imran7976/automated-waste-segregation-robot/hardware/bill_of_materials.md

# Itemized Bill of Materials (BOM) & Turnkey Cost Analysis

The prototype was constructed with extreme affordability as a primary engineering objective, achieving full functionality at under $50 USD. The procurement invoices are itemized below in Bangladeshi Taka (BDT) and US Dollars (USD).

| Subsystem Component | Model / Specifications | Qty | Unit Cost (BDT) | Total Cost (BDT) | Cost (USD) |
| :--- | :--- | :---: | :---: | :---: | :---: |
| **4-DOF Arm Frame** | 3D-Printed High-Tensile PLA Frame (45% infill, 0.2 mm layer) | 1 | 2,800 BDT | 2,800 BDT | $23.89 |
| **Microcontroller Unit (MCU)** | Arduino Uno R3 (ATmega328P, 16 MHz, 32 KB Flash) | 1 | 988 BDT | 988 BDT | $8.43 |
| **Actuator Servomotors** | TowerPro MG90S Digital Micro-Servos (Metal Gear, 2.2 kg·cm) | 4 | 209 BDT | 836 BDT | $7.13 |
| **DC-DC Buck Converter** | LM2596 Step-Down Switching Regulator (150 kHz, 2.0A rated) | 1 | 245 BDT | 245 BDT | $2.09 |
| **Rechargeable Battery** | IMR 18650 Li-ion Cells (HYLN 25826, 3.7V, 2000 mAh each) | 2 | 148 BDT | 296 BDT | $2.53 |
| **Ingress Detection Sensor** | Active-Low IR Obstacle Module (GaAs Emitter, LM393, 2–30 cm) | 1 | 40 BDT | 40 BDT | $0.34 |
| **Moisture Detection Sensor** | FR-04 Double-Sided Nickel Plate with LM393 Comparator | 1 | 83 BDT | 83 BDT | $0.71 |
| **Inductive Proximity Sensor**| LJ12A3-4-Z/BX (M12, NPN NO, 4.0 mm, 100 Hz Osc.) | 1 | 495 BDT | 495 BDT | $4.22 |
| **Total Hardware Cost** | **Turnkey Automated Waste Sorting Platform** | -- | -- | **5,783 BDT** | **≈ $49.34** |

> *Currency conversion baseline: $1.00\text{ USD} \approx 117.20\text{ BDT}$.*

---

## Economic Viability Comparison
Compared to commercial vision-guided robotic sorting installations that typically exceed $50,000–$100,000 USD in capital investment, EcoSort demonstrates that autonomous 4-DOF multi-material segregation is viable at decentralized municipal collection points for under **$50 USD**.
