imran7976/automated-waste-segregation-robot/(commit log)

2026-11-02 docs: replace prototype image and diagrams with authentic figures from conference paper
2026-11-02 docs: restore original Mermaid flow diagram, retain only Fig 1 (paper prototype) and Fig 2 (kinematics simulation)
2026-11-02 firmware: align Arduino firmware with hardware-verified physical implementation
